hupf/korpus/Korpus.FCStd

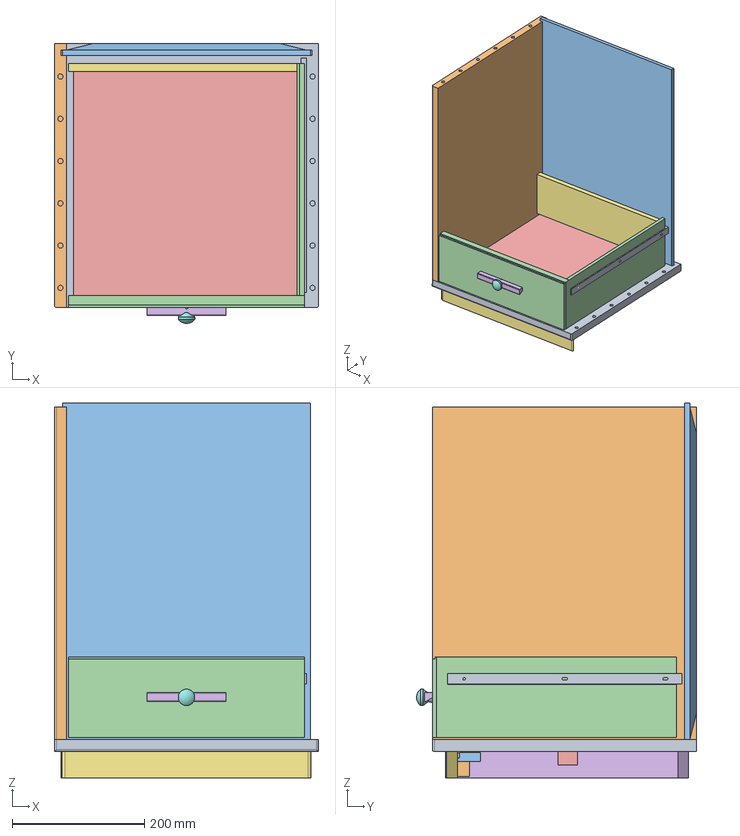
[picture p1: CAD file, 2026-11-05]
Korpus.FCStd
400.0 x 424.0 x 568.0 mm
Unterseite
Linke Seite
Hinterseite
Schubladenfront
Festpunkt links
Griff Eiche geschwärzt
Hinterstück
Knopf Nussbaum
Laufleiste rechts
Leimklotz vorne links
Nutklotz
Seite rechts
Boden
Sockel links
Sockel vorne
