hupf/korpus/(commit log)

2026-10-22 Add Dübel
    [Korpus.FCStd]
2026-10-29 Add drawer
    [Korpus.FCStd]
2026-11-05 Add runner screw holes and dovetail layout
    - Laufleisten: Festpunkt vorne, Langlöcher Mitte/hinten, zylindrische
    Ansenkung (Spreadsheet-Zeilen 78–82)
    - Zinkenteilung als Regeln in den Projektnotizen, Zeichnung mit Skript
    in Zeichnungen/
    - Lista LO Mini-Caddy als Herkunft der Hauptmasse und Inspiration
    [Korpus.FCStd]
